vgeorge/coldsnap/images/Coldsnap_3-1.jpg

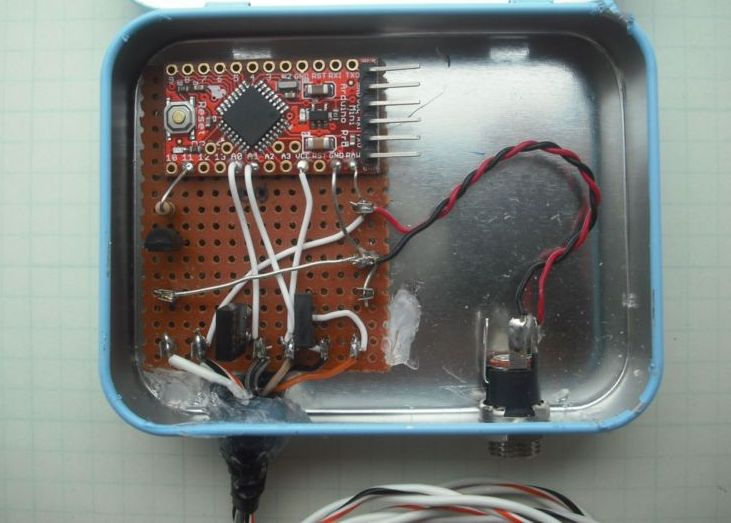
images/Coldsnap_3-1.jpg
