vgeorge/coldsnap/images/ColdSnap_01_top-1.jpg

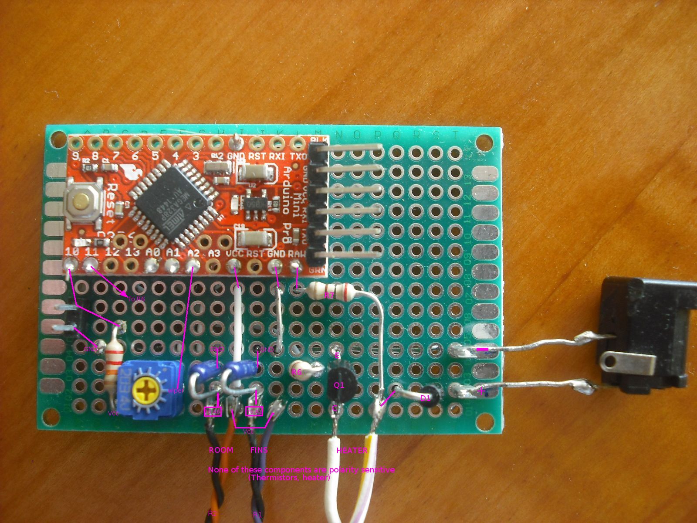
images/ColdSnap_01_top-1.jpg
