vgeorge/coldsnap/images/ColdSnap_01_bottom-1.jpg

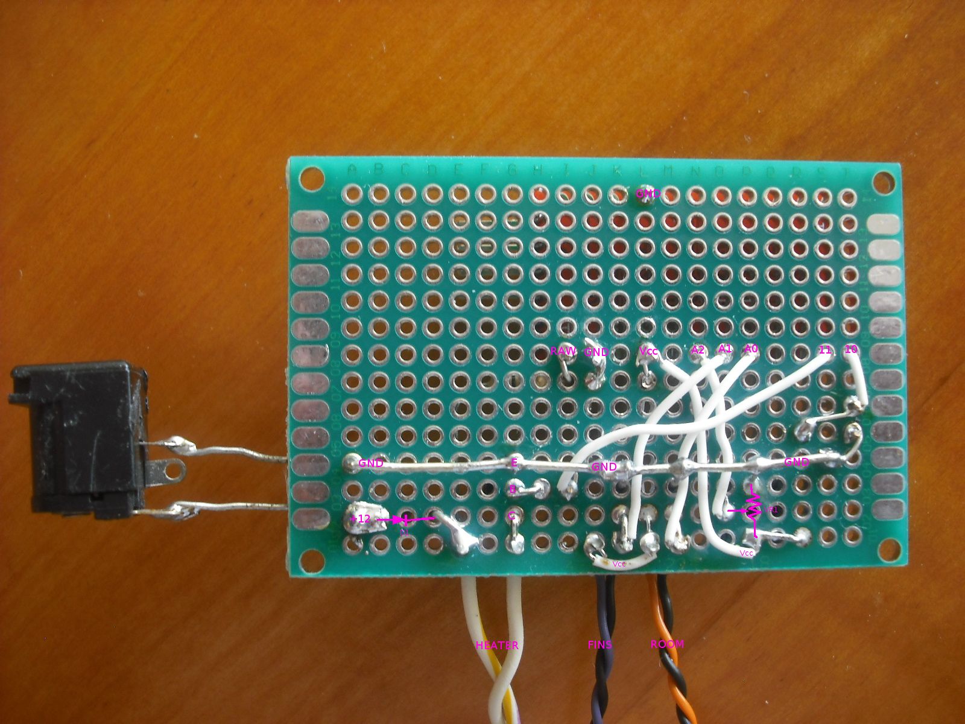
images/ColdSnap_01_bottom-1.jpg
