vgeorge/coldsnap/images/Controller_01.png

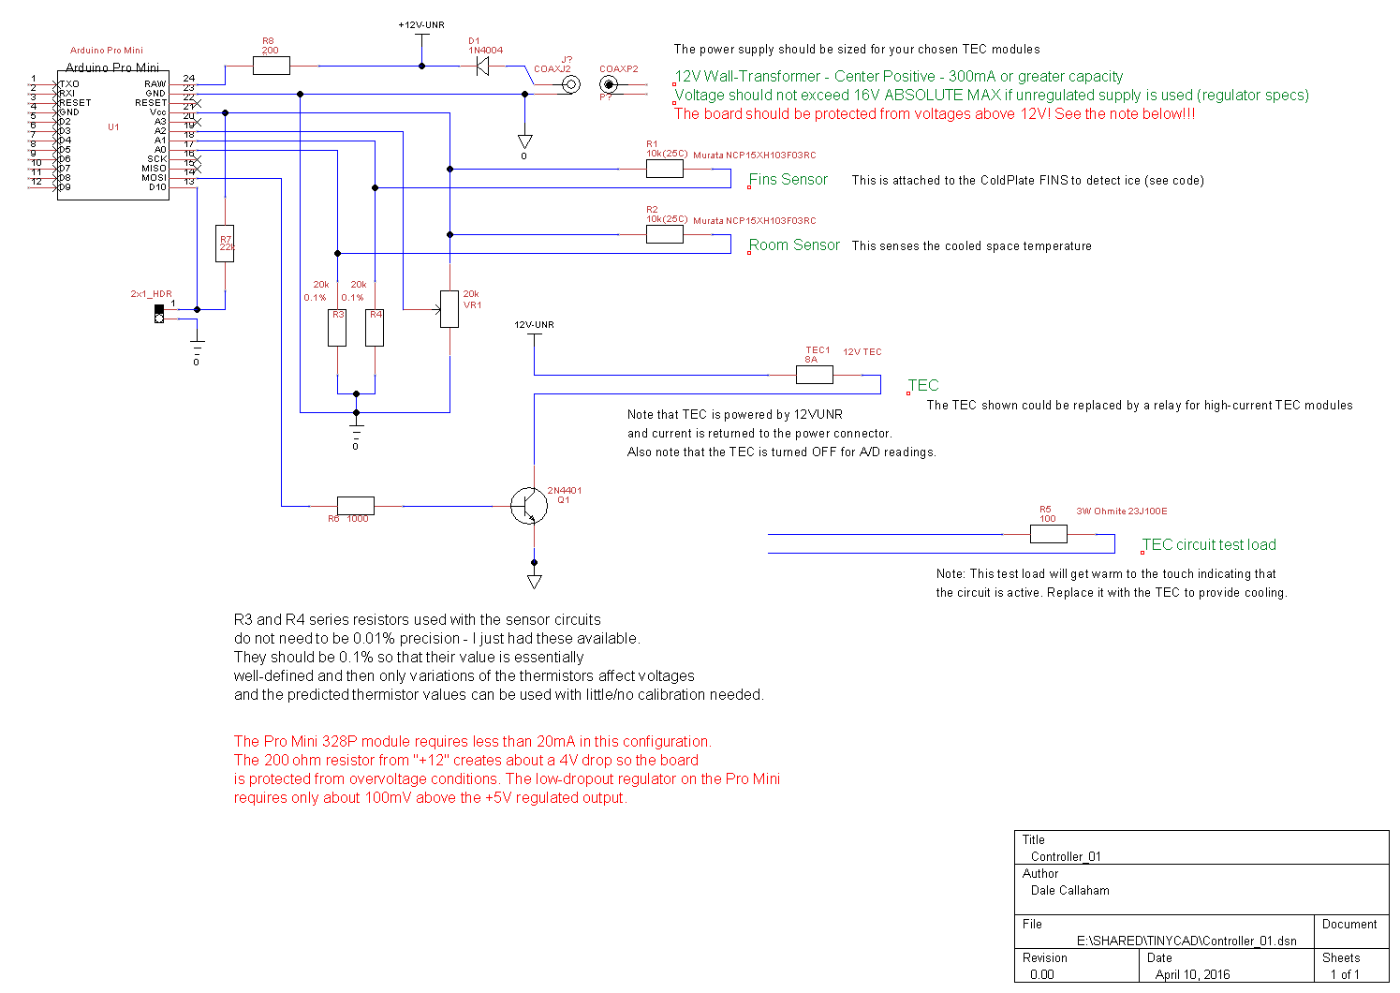
images/Controller_01.png
