vgeorge/coldsnap/images/ProMini+FTDI-Basic-1.jpg

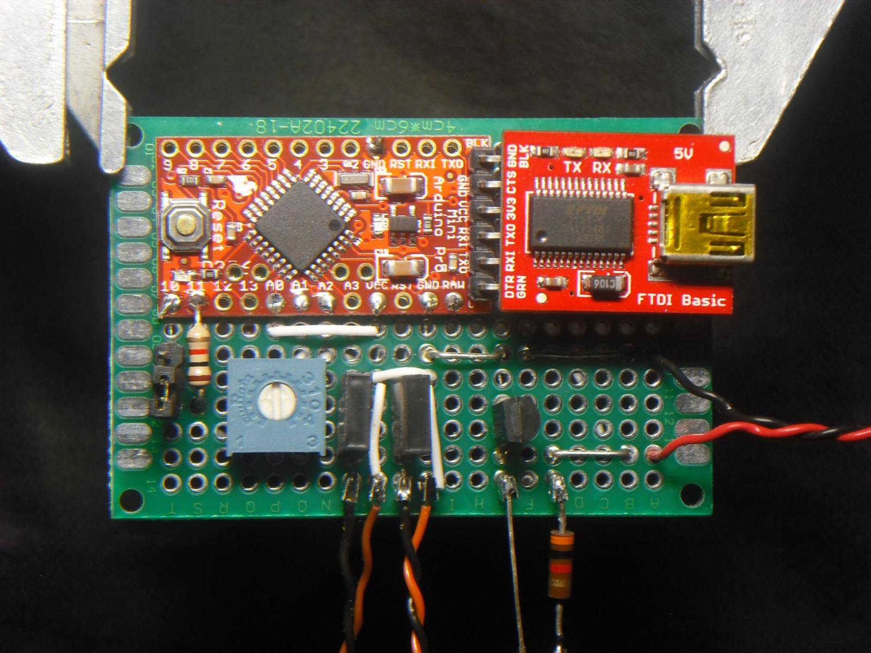
images/ProMini+FTDI-Basic-1.jpg
