vgeorge/coldsnap/(commit log)

2018-06-11 Wiring diagram
    ColdSnap wiring diagram
2018-06-16 100K thermistor version
    100K thermistor version running full off of 5V only with 10ohms resistor.
